Ledger-Donjon/curmea/(commit log)

2024-04-29 Update Curmea
    [Curmea.kicad_pcb, Curmea.kicad_sch]
2024-04-29 Remove major DRC errors
    [Curmea.kicad_pcb]
2024-04-29 Remove major DRC errors cont'd
    [Curmea.kicad_pcb]
2024-04-29 Add potentiometer in input
    [Curmea.kicad_pcb, Curmea.kicad_sch]
2024-06-04 Small final updates
    [Curmea.kicad_pcb, Curmea.kicad_sch]
2024-06-06 Adding diodes and changing package size for resistors.
    [Curmea.kicad_pcb, Curmea.kicad_sch]
2024-10-13 Fix the input resistance position
    [Curmea.kicad_pcb, Curmea.kicad_sch]
2024-10-18 Generate gerber files
    [Curmea-B_Cu.gbr, Curmea-B_Mask.gbr, Curmea-B_Paste.gbr, Curmea-B_Silkscreen.gbr, Curmea-Edge_Cuts.gbr, Curmea-F_Cu.gbr, Curmea-F_Mask.gbr, Curmea-F_Paste.gbr]
